SreekarReddyArepally/Quadrature-Down-Converter/LT_Plots/Q-2/hardware_osc_freq.jpeg

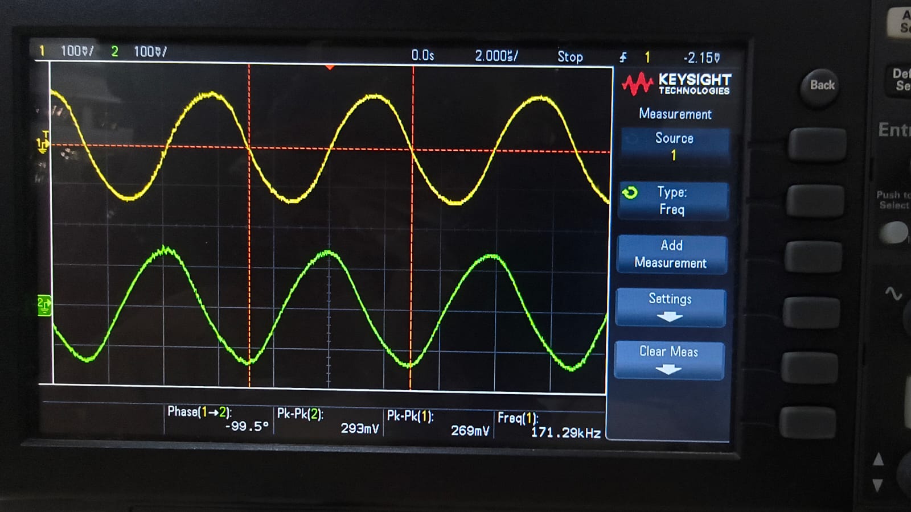
LT_Plots/Q-2/hardware_osc_freq.jpeg
