SreekarReddyArepally/Quadrature-Down-Converter/LT_Plots/Q-3/hardware_171khz_tran.jpeg

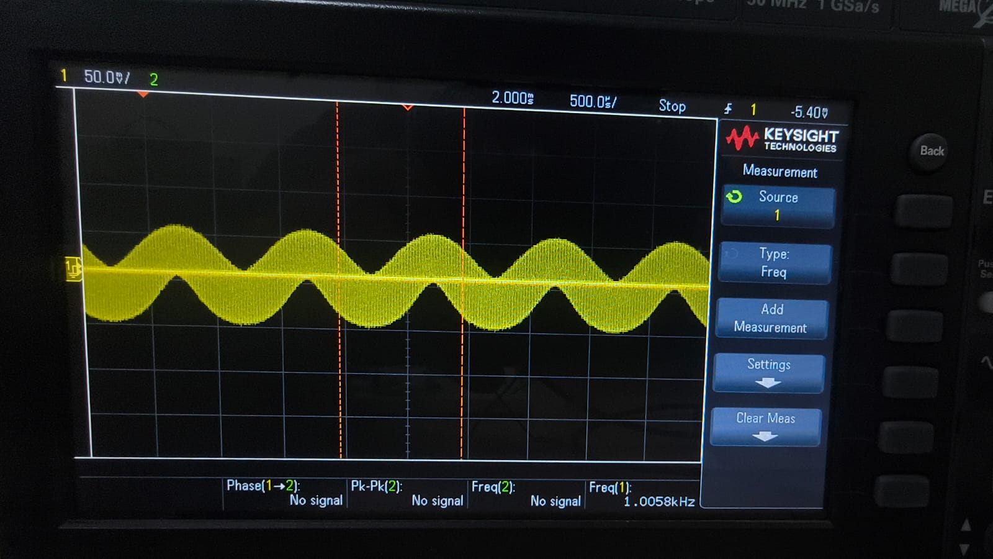
LT_Plots/Q-3/hardware_171khz_tran.jpeg
