SreekarReddyArepally/Quadrature-Down-Converter/LT_Plots/Q-2/Freq.png

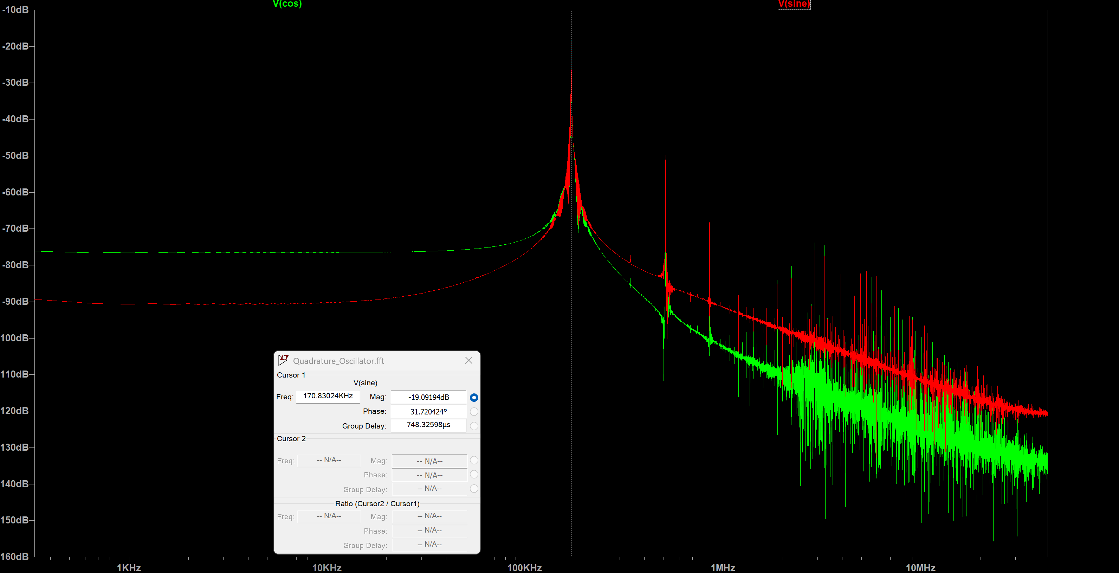
LT_Plots/Q-2/Freq.png
