SreekarReddyArepally/Quadrature-Down-Converter/LT_Plots/Q-2/Freq_Phase.png

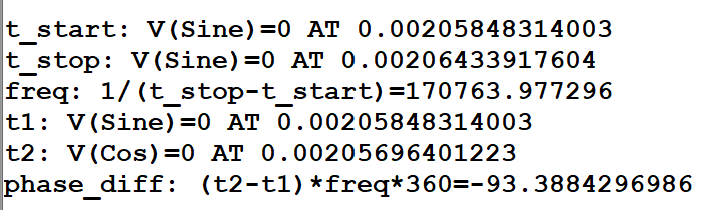
LT_Plots/Q-2/Freq_Phase.png
