SreekarReddyArepally/Quadrature-Down-Converter/LT_Plots/Q-3/168k_FFT.png

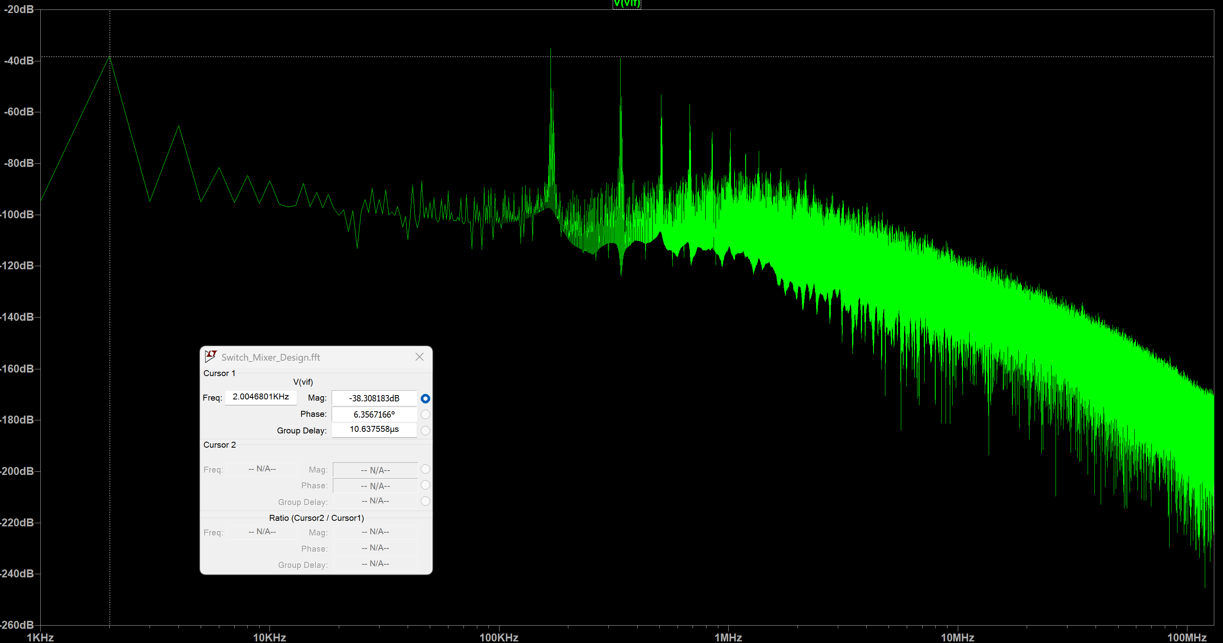
LT_Plots/Q-3/168k_FFT.png
