SreekarReddyArepally/Quadrature-Down-Converter/LT_Plots/Q-3/169k_FFT.png

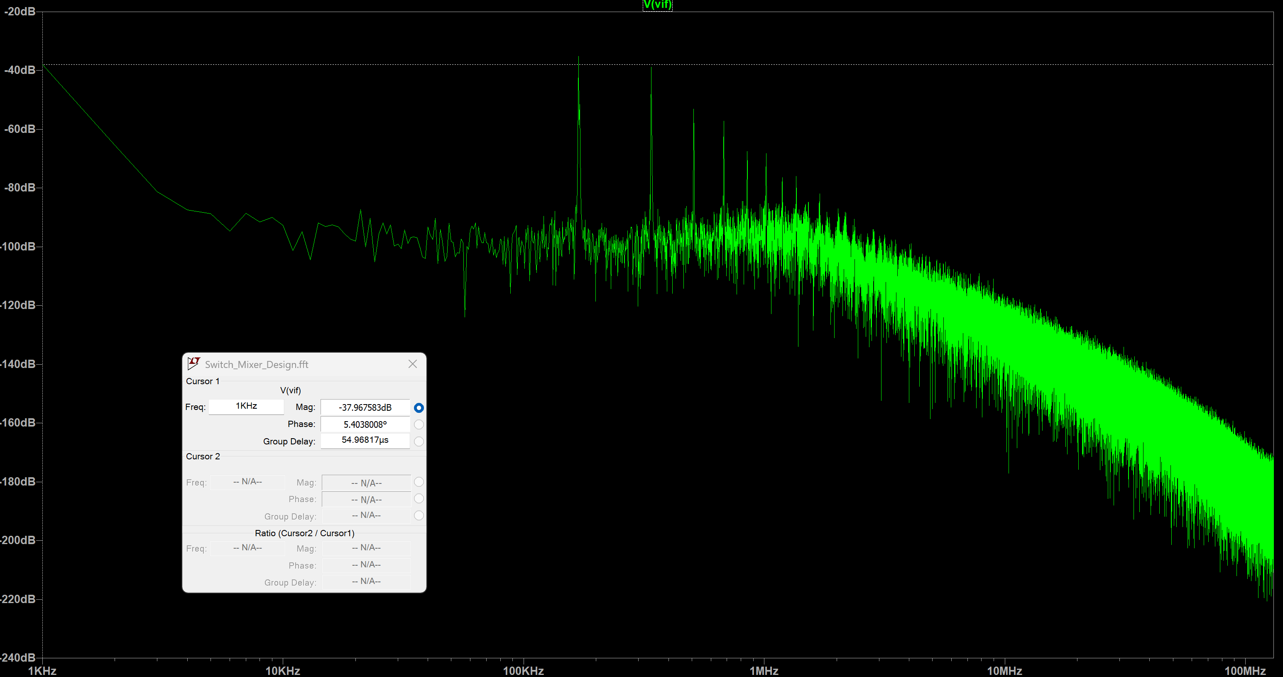
LT_Plots/Q-3/169k_FFT.png
