SreekarReddyArepally/Quadrature-Down-Converter/LT_Plots/Q-3/169k_Tran.png

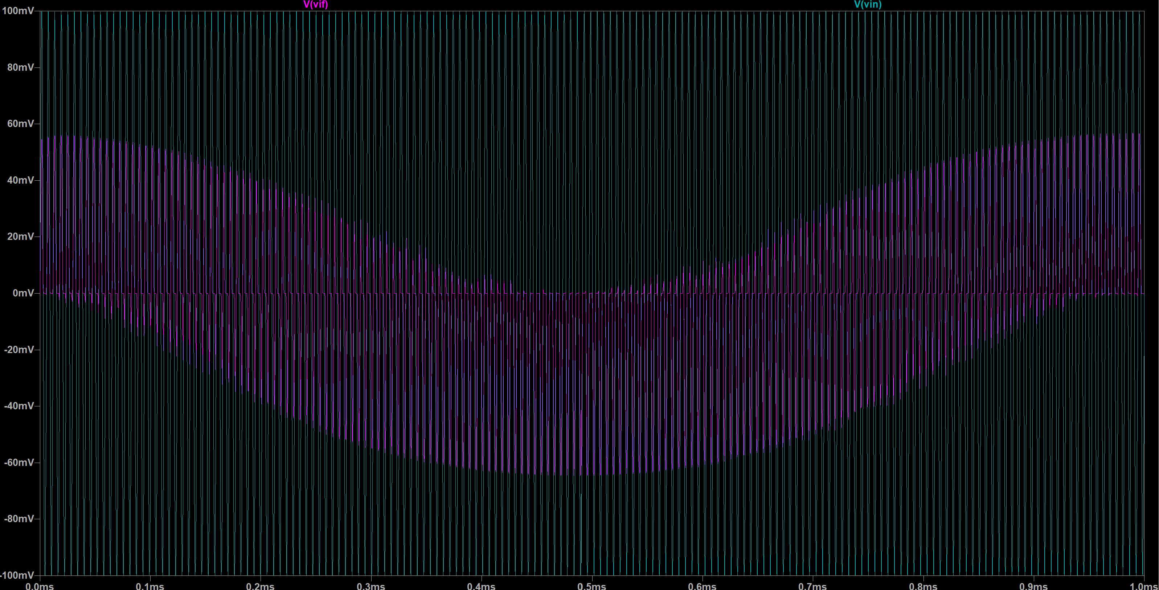
LT_Plots/Q-3/169k_Tran.png
