SreekarReddyArepally/Quadrature-Down-Converter/LT_Plots/Q-3/171k_Tran.png

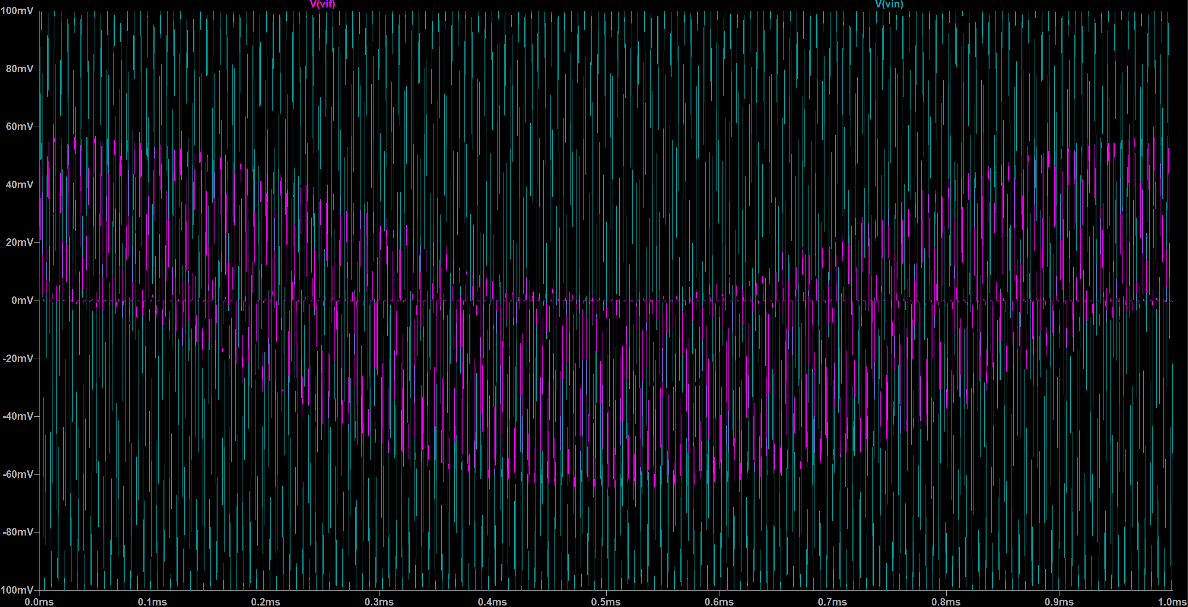
LT_Plots/Q-3/171k_Tran.png
