SreekarReddyArepally/Quadrature-Down-Converter/LT_Plots/Q-4/1k_Tran.png

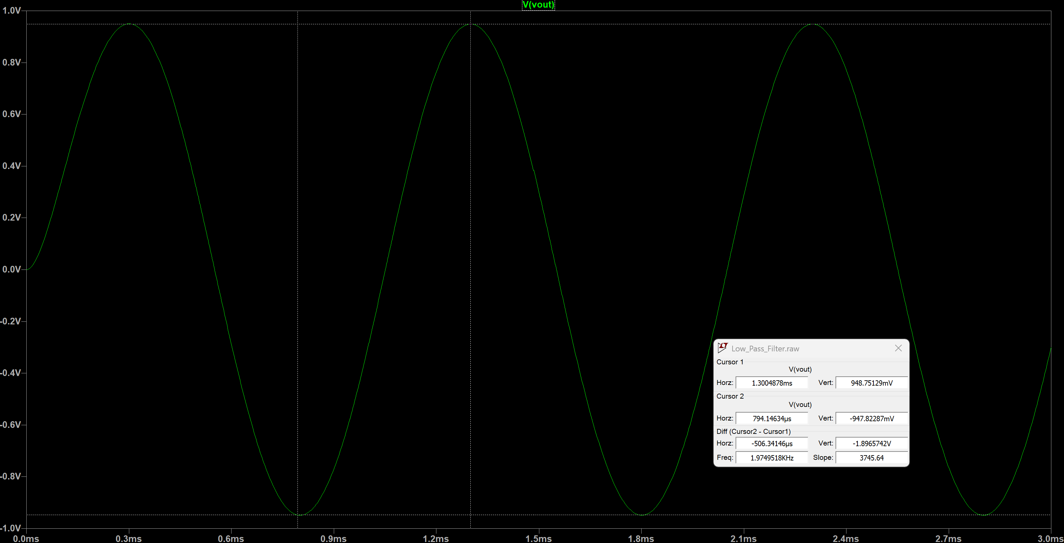
LT_Plots/Q-4/1k_Tran.png
