SreekarReddyArepally/Quadrature-Down-Converter/LT_Plots/Q-4/165k_tran.png

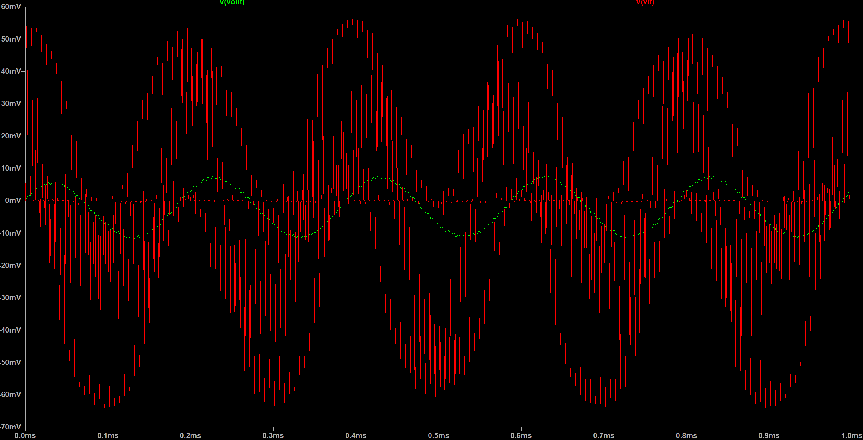
LT_Plots/Q-4/165k_tran.png
