SreekarReddyArepally/Quadrature-Down-Converter/LT_Plots/Q-4/168k_fft.png

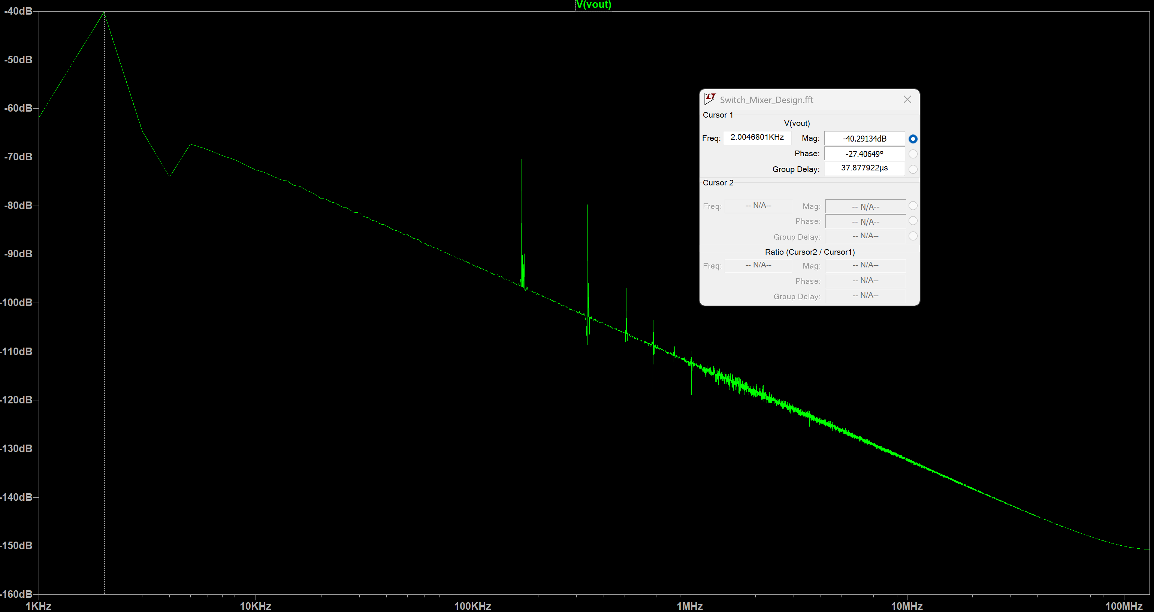
LT_Plots/Q-4/168k_fft.png
