SreekarReddyArepally/Quadrature-Down-Converter/LT_Plots/Q-4/168k_tran.png

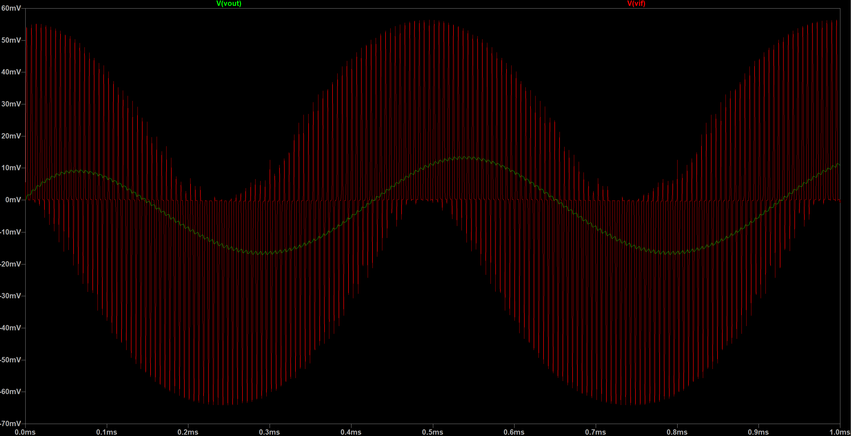
LT_Plots/Q-4/168k_tran.png
