SreekarReddyArepally/Quadrature-Down-Converter/LT_Plots/Q-4/169k_fft.png

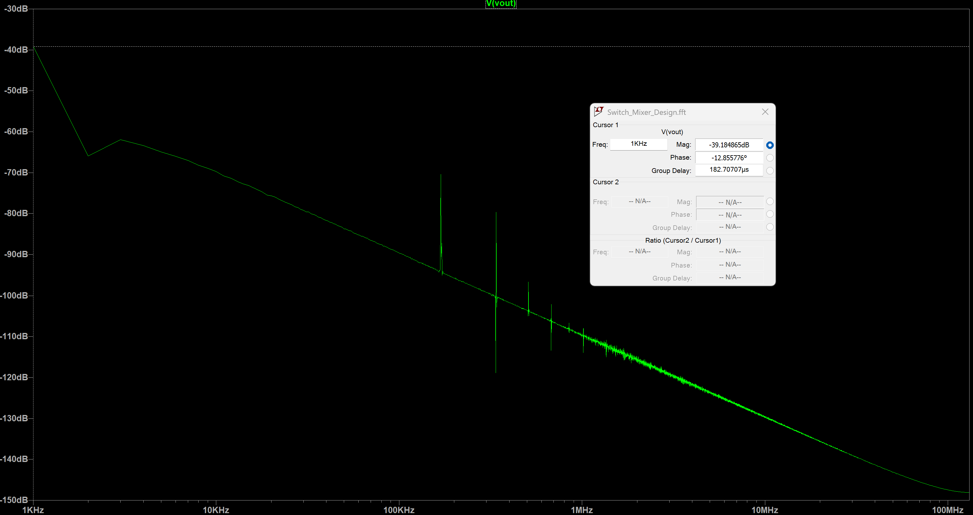
LT_Plots/Q-4/169k_fft.png
