SreekarReddyArepally/Quadrature-Down-Converter/LT_Plots/Q-4/amplifier_simulation_cursor_bottom.png

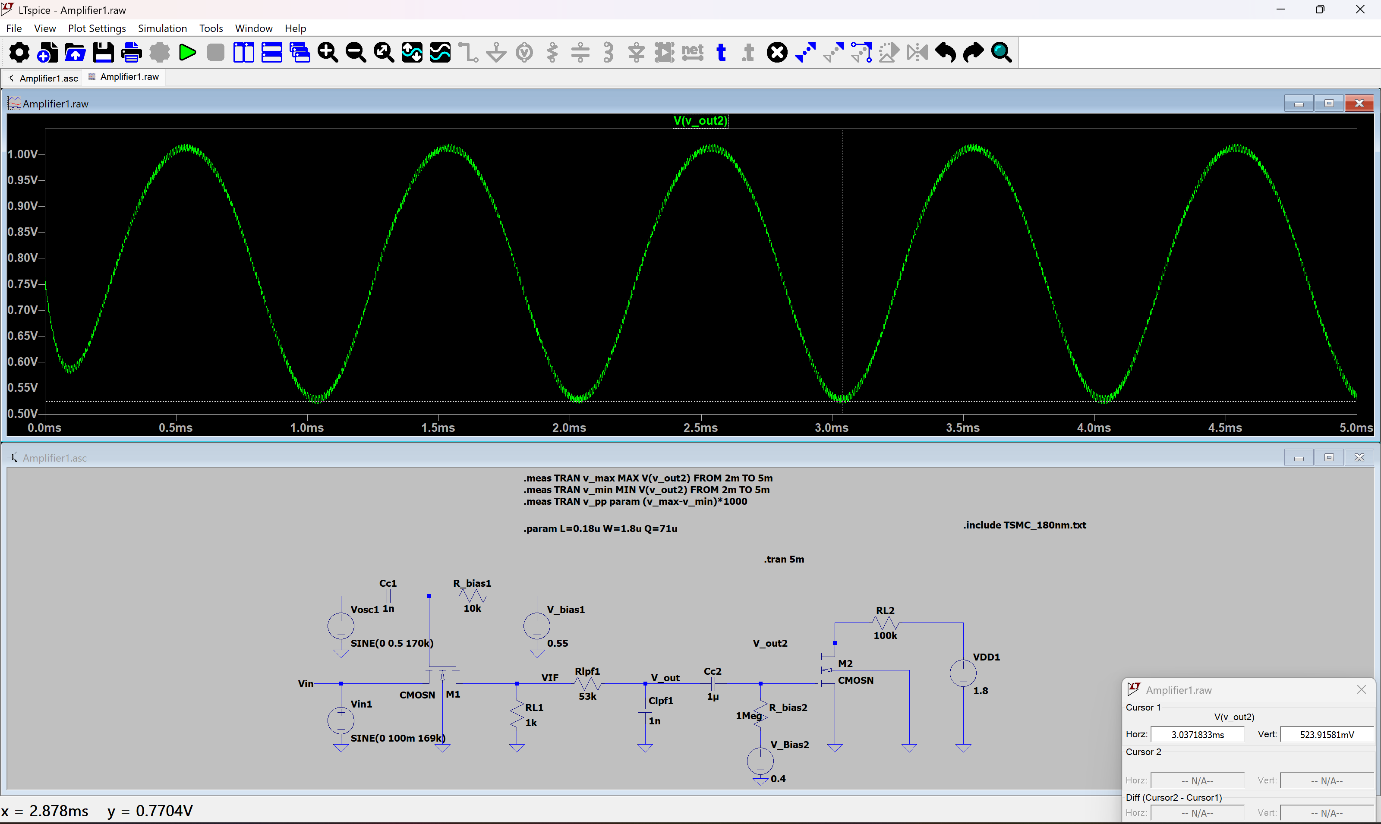
LT_Plots/Q-4/amplifier_simulation_cursor_bottom.png
