SreekarReddyArepally/Quadrature-Down-Converter/LT_Plots/Q-4/Circuit_q4.png

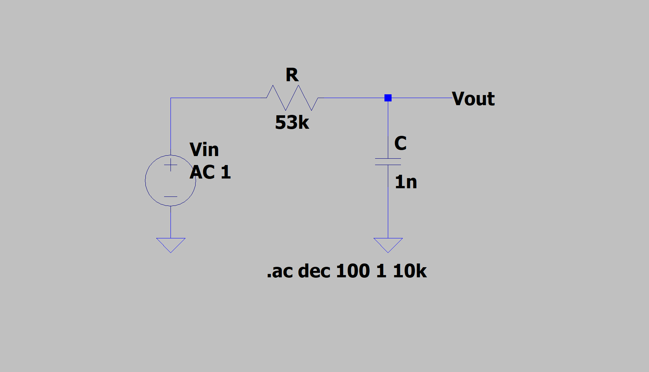
LT_Plots/Q-4/Circuit_q4.png
