SreekarReddyArepally/Quadrature-Down-Converter/LT_Plots/Q-4/hardware5khz.jpeg

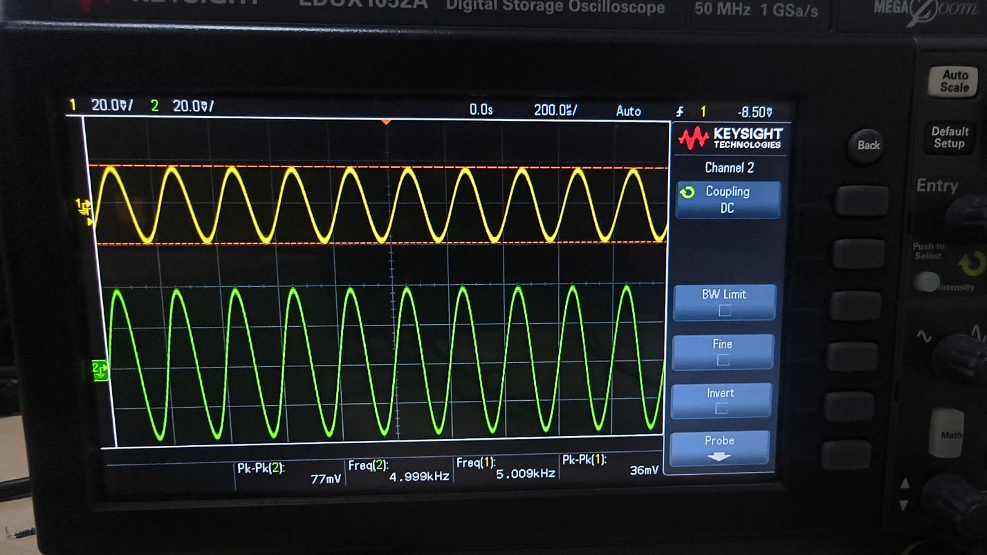
LT_Plots/Q-4/hardware5khz.jpeg
