SreekarReddyArepally/Quadrature-Down-Converter/LT_Plots/Q-4/hardware6khz.jpeg

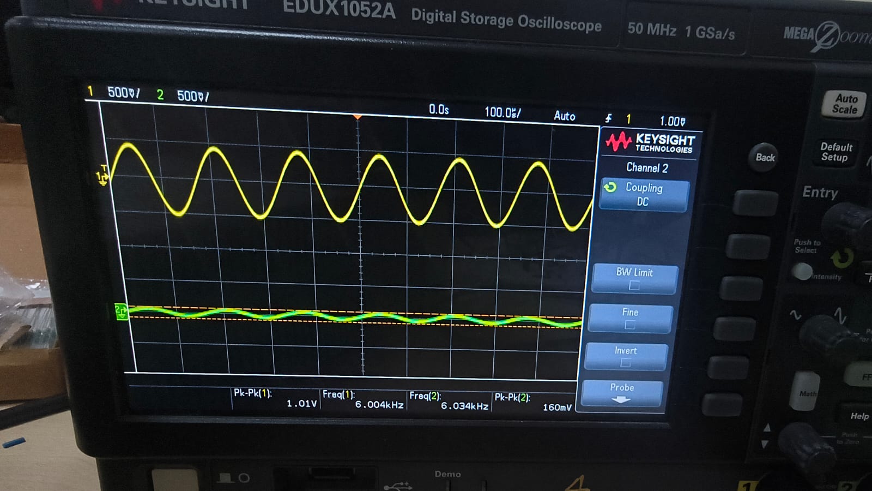
LT_Plots/Q-4/hardware6khz.jpeg
