SreekarReddyArepally/Quadrature-Down-Converter/LT_Plots/Q-4/hardware7khz.jpeg

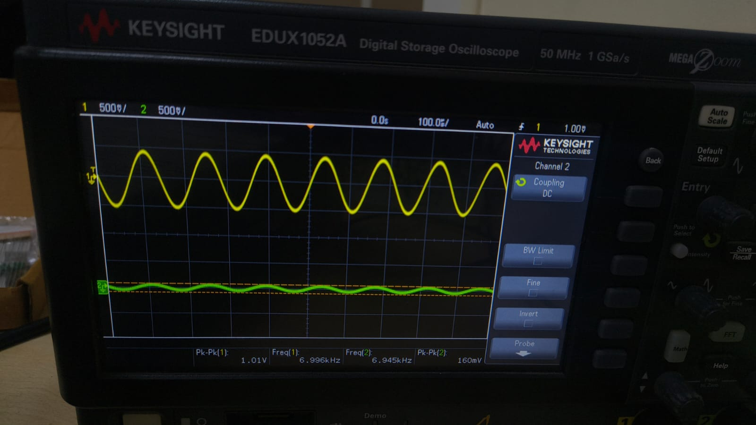
LT_Plots/Q-4/hardware7khz.jpeg
