SreekarReddyArepally/Quadrature-Down-Converter/LT_Plots/Q-5/Freq_Phase_Amp.png

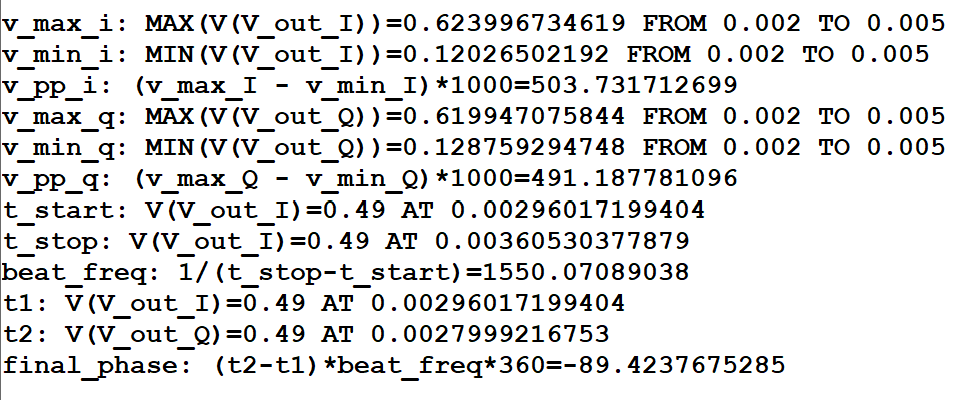
LT_Plots/Q-5/Freq_Phase_Amp.png
