SreekarReddyArepally/Quadrature-Down-Converter/Sims/Final_Design.asc

C1: cap; 1n
C2: cap; 1n
Cc1: cap; 1n
Cc2: cap; 1µ
Cc3: cap; 1n
Cc4: cap; 1µ
Clpf1: cap; 1n
Clpf2: cap; 1n
Clpf3: cap; 1n
Clpf4: cap; 1n
D1: diode; 1N4148
D2: diode; 1N4148
M1: nmos4; CMOSN; l=L w=W ad=5*L*W/2 as=5*L*W/2 pd=5*L+2*W ps=5*L+2*W
M2: nmos4; CMOSN; l=L w=Q ad=5*L*Q/2 as=5*L*Q/2 pd=5*L+2*Q ps=5*L+2*Q
M3: nmos4; CMOSN; l=L w=W ad=5*L*W/2 as=5*L*W/2 pd=5*L+2*W ps=5*L+2*W
M4: nmos4; CMOSN; l=L w=Q ad=5*L*Q/2 as=5*L*Q/2 pd=5*L+2*Q ps=5*L+2*Q
R1: res; {R}
R2: res; {R}
R3: res; 330
R4: res; {R}
R5: res; {R}
R6: res; 620
R7: res; 10k
R8: res; 12k
R9: res; 1k
R10: res; 1k
R_bias1: res; 10k
R_bias2: res; 1Meg
R_bias3: res; 10k
R_bias4: res; 1Meg
RL1: res; 10k
RL2: res; 120k
RL3: res; 10k
RL4: res; 120k
Rlpf1: res; 55.5k
Rlpf2: res; 55.5k
Rlpf3: res; 55.5k
Rlpf4: res; 55.5k
U1: UA741
U2: UA741
U3: UA741
V1: voltage; 12
V2: voltage; 12
V_bias1: voltage; 0.55
V_Bias2: voltage; 0.42
V_bias3: voltage; 0.55
V_Bias4: voltage; 0.42
VDD1: voltage; 1.8
VDD2: voltage; 1.8
Vin1: voltage; SINE(0 100m 169k)
Named nets: 0, Sine, Cos, VIF_Q, V_out1_Q, V_out_Q, VIF_I, V_out1_I, V_out_I, V_out2_I, V_out2_Q
.tran 10m
.include UA741.301
.param R=10k
.include TSMC_180nm.txt
.param L=0.18u W=1.8u Q=71u
*--- I-Channel Measurements ---
.meas TRAN v_max_I MAX V(V_out_I) FROM 2m TO 5m
.meas TRAN v_min_I MIN V(V_out_I) FROM 2m TO 5m
.meas TRAN v_pp_I param (v_max_I - v_min_I)*1000
 
*--- Q-Channel Measurements ---
.meas TRAN v_max_Q MAX V(V_out_Q) FROM 2m TO 5m
.meas TRAN v_min_Q MIN V(V_out_Q) FROM 2m TO 5m
.meas TRAN v_pp_Q param (v_max_Q - v_min_Q)*1000
*--- Beat Frequency Measurement ---
.meas TRAN t_start WHEN V(V_out_I)=0.49 RISE=2 TD=2.0m
.meas TRAN t_stop WHEN V(V_out_I)=0.49 RISE=3 TD=2.0m
.meas TRAN beat_freq param 1/(t_stop-t_start)
 
*--- Final Phase Difference ---
.meas TRAN t1 WHEN V(V_out_I)=0.49 RISE=2 TD=2.0m
.meas TRAN t2 WHEN V(V_out_Q)=0.49 RISE=2 TD=2.0m
.meas TRAN final_phase param (t2-t1)*beat_freq*360
