SreekarReddyArepally/Quadrature-Down-Converter/Sims/Switch_Mixer_Design.asc

Cc: cap; 1n
Clpf: cap; 1n
M1: nmos4; CMOSN; l=L w=W ad=5*L*W/2 as=5*L*W/2 pd=5*L+2*W ps=5*L+2*W
Rbias: res; 10k
RL: res; 1k
Rlpf: res; 53k
Vbias: voltage; 0.55
Vin: voltage; SINE(0 100m 175k)
Vosc: voltage; SINE(0 0.5 170k)
Named nets: 0, VIF, Vin, Vout
.include TSMC_180nm.txt
.param L=0.18u W=1.8u
.tran 1m
