SreekarReddyArepally/Quadrature-Down-Converter/Sims/Amplifier1.asc

Cc1: cap; 1n
Cc2: cap; 1µ
Clpf1: cap; 1n
M1: nmos4; CMOSN; l=L w=W ad=5*L*W/2 as=5*L*W/2 pd=5*L+2*W ps=5*L+2*W
M2: nmos4; CMOSN; l=L w=Q ad=5*L*Q/2 as=5*L*Q/2 pd=5*L+2*Q ps=5*L+2*Q
R_bias1: res; 10k
R_bias2: res; 1Meg
RL1: res; 1k
RL2: res; 100k
Rlpf1: res; 53k
V_bias1: voltage; 0.55
V_Bias2: voltage; 0.4
VDD1: voltage; 1.8
Vin1: voltage; SINE(0 100m 169k)
Vosc1: voltage; SINE(0 0.5 170k)
Named nets: 0, VIF, Vin, V_out, V_out2
.include TSMC_180nm.txt
.param L=0.18u W=1.8u Q=71u
.tran 5m
.meas TRAN v_max MAX V(v_out2) FROM 2m TO 5m
.meas TRAN v_min MIN V(v_out2) FROM 2m TO 5m
.meas TRAN v_pp param (v_max-v_min)*1000
