SreekarReddyArepally/Quadrature-Down-Converter/Sims/Lab_Amplifier.asc

Cc1: cap; 1n
Cc2: cap; 1µ
Clpf1: cap; 1n
M1: nmos4; NMOS_CD4007; l=5u w=170u
M2: nmos4; NMOS_CD4007; l=5u w=170u
R_bias1: res; 10k
R_bias2: res; 1Meg
RL1: res; 1k
RL: res; 100k
Rlpf1: res; 55.5k
V_bias1: voltage; 1.5
V_bias2: voltage; 1.6
VDD: voltage; 3
Vin1: voltage; SINE(0 100m 169k)
Vosc1: voltage; SINE(0 0.5 170k)
Named nets: 0, VIF, Vin, V_out, V_out2
.tran 5m
.include cd4007.lib
.meas TRAN v_max MAX V(v_out2) FROM 2m TO 5m
.meas TRAN v_min MIN V(v_out2) FROM 2m TO 5m
.meas TRAN v_pp param (v_max-v_min)*1000
