SreekarReddyArepally/Quadrature-Down-Converter/Sims/Low_Pass_Filter.asc

C: cap; 1n
R: res; 53k
Vin: voltage; SINE(0 1 10k)
Named nets: 0, Vout
.tran 3m
