SreekarReddyArepally/Quadrature-Down-Converter/Sims/Quadrature_Oscillator.asc

C1: cap; 1n
C2: cap; 1n
D1: diode; 1N4148
D2: diode; 1N4148
R1: res; {R}
R2: res; {R}
R3: res; 330
R4: res; {R}
R5: res; {R}
R6: res; 620
R7: res; 10k
R8: res; 12.16k
R9: res; 0
R10: res; 0
U1: UA741
U2: UA741
U3: UA741
V1: voltage; 12
V2: voltage; 12
Named nets: 0, Sine, Cos
.tran 3m
.include UA741.301
.param R=10k
.meas TRAN t_start WHEN V(Sine)=0 RISE=10 TD=2.0m
.meas TRAN t_stop WHEN V(Sine)=0 RISE=11 TD=2.0m
.meas TRAN freq param 1/(t_stop-t_start)
.meas TRAN t1 WHEN V(Sine)=0 RISE=10 TD=2.0m
.meas TRAN t2 WHEN V(Cos)=0 RISE=10 TD=2.0m
.meas TRAN phase_diff param (t2-t1)*freq*360
